Saatvik-Aggarwal/phased-array/README.md

# phased-array
Simulation and design of a phased array for wireless power transmission
