Saatvik-Aggarwal/phased-array/RX Antenna/Rx antenna.kicad_pcb

## KiCad design RX Antenna/Rx antenna.kicad_pcb (2026-04-08)

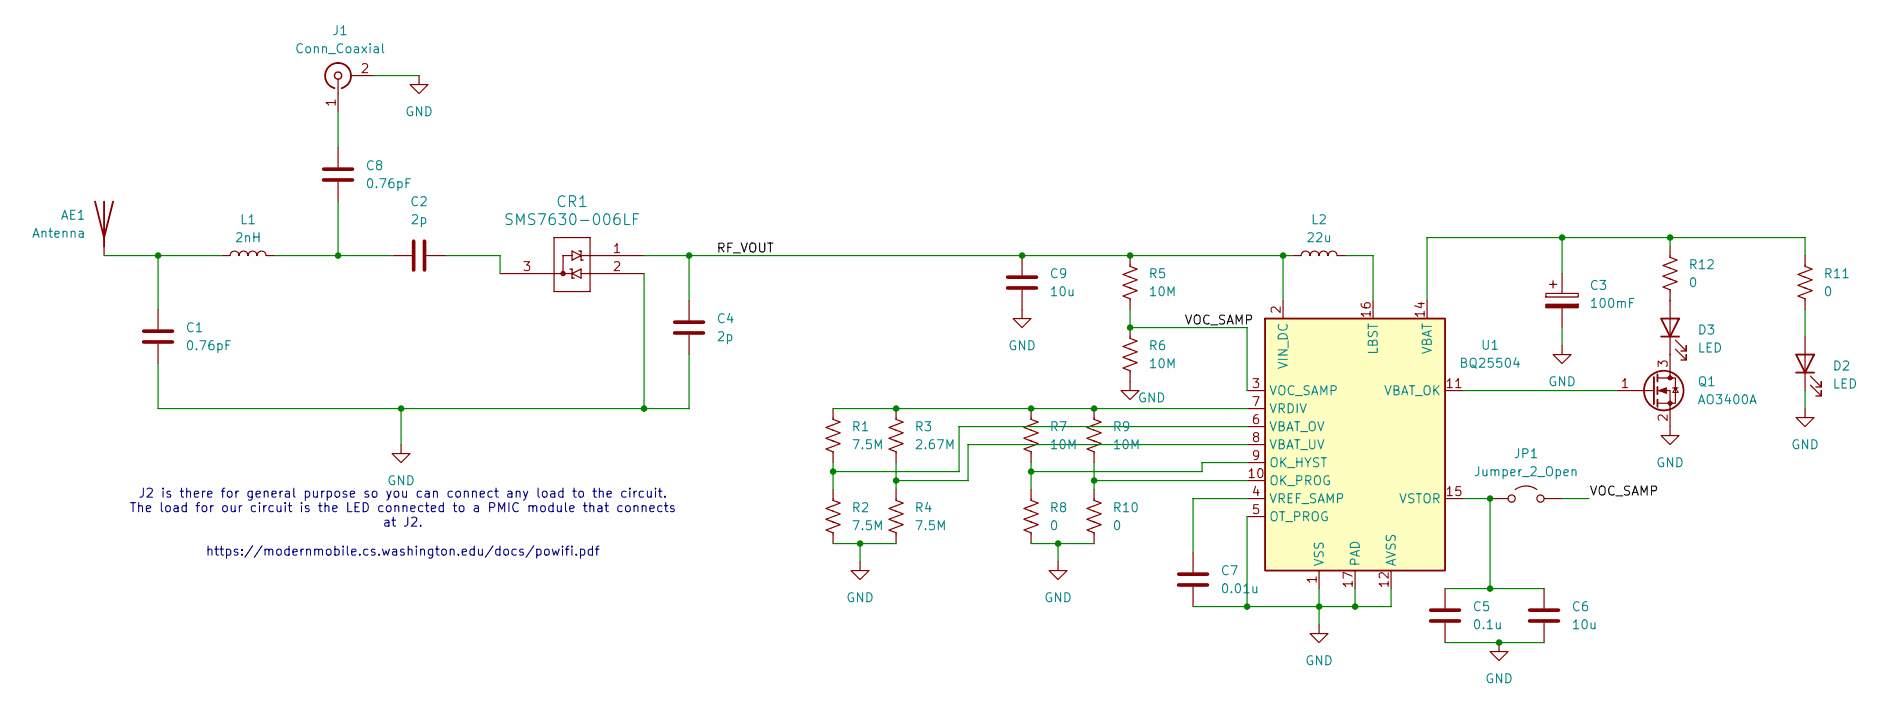
[picture p1: schematic Rx antenna.kicad_sch]

Parts:
AE1: Antenna; AperturePatch
C1: 0.76pF; C_0201_0603Metric_Pad0.64x0.40mm_HandSolder
C2, C4: 2p; C_0201_0603Metric_Pad0.64x0.40mm_HandSolder
C3: 100mF; CP_Radial_D10.0mm_P5.00mm
C5: 0.1u; C_0603_1608Metric_Pad1.08x0.95mm_HandSolder
C6, C9: 10u; C_0603_1608Metric_Pad1.08x0.95mm_HandSolder
C7: 0.01u; C_0603_1608Metric_Pad1.08x0.95mm_HandSolder
C8: 0.76pF; C_0201_branch
CR1: SMS7630-006LF; SOT-23
D2, D3: LED; LED_0603_1608Metric_Pad1.05x0.95mm_HandSolder
J1: Conn_Coaxial; U.FL_Hirose_U.FL-R-SMT-1_Vertical
JP1: Jumper_2_Open; SolderJumper-2_P1.3mm_Open_RoundedPad1.0x1.5mm
L1: 2nH; L_0201_0603Metric_Pad0.64x0.40mm_HandSolder
L2: 22u; L_1210_3225Metric_Pad1.42x2.65mm_HandSolder
Q1: AO3400A; SOT-23
R1, R2, R4: 7.5M; R_0603_1608Metric_Pad0.98x0.95mm_HandSolder
R3: 2.67M; R_0603_1608Metric_Pad0.98x0.95mm_HandSolder
R5, R6, R7, R9: 10M; R_0603_1608Metric_Pad0.98x0.95mm_HandSolder
R8, R10, R11, R12: 0; R_0603_1608Metric_Pad0.98x0.95mm_HandSolder
U1: BQ25504; VQFN-16-1EP_3x3mm_P0.5mm_EP1.68x1.68mm

Connections:
/RF_VOUT: C4.1, C9.1, CR1.1, L2.1, R5.1, U1.2 (VIN_DC)
/VOC_SAMP: JP1.2 (B), R5.2, R6.1, U1.3 (VOC_SAMP)
GND: C1.2, C3.2, C4.2, C5.2, C6.2, C7.2, C9.2, CR1.2, D2.1 (K), J1.2 (Ext), Q1.2 (S), R2.2, R4.2, R6.2, R8.2, R10.2, U1.1 (VSS), U1.5 (OT_PROG), U1.12 (AVSS), U1.13 (VSS), U1.17 (PAD)
unnamed: AE1.1 (A_1), C1.1, L1.1
unnamed: C2.1, C8.1, L1.2
unnamed: C2.2, CR1.3
unnamed: D2.2 (A), R11.2
unnamed: D3.2 (A), R12.2
unnamed: D3.1 (K), Q1.3 (D)
unnamed: C8.2, J1.1 (In)
unnamed: C5.1, C6.1, JP1.1 (A), U1.15 (VSTOR)
unnamed: Q1.1 (G), U1.11 (VBAT_OK)
unnamed: L2.2, U1.16 (LBST)
unnamed: R7.2, R8.1, U1.9 (OK_HYST)
unnamed: R9.2, R10.1, U1.10 (OK_PROG)
unnamed: C3.1, R11.1, R12.1, U1.14 (VBAT)
unnamed: R1.2, R2.1, U1.6 (VBAT_OV)
unnamed: R3.2, R4.1, U1.8 (VBAT_UV)
unnamed: R1.1, R3.1, R7.1, R9.1, U1.7 (VRDIV)
unnamed: C7.1, U1.4 (VREF_SAMP)

Notes on the sheet:
J2 is there for general purpose so you can connect any load to the circuit. The load for our circuit is the LED connected to a PMIC module that connects at J2. https://modernmobile.cs.washington.edu/docs/powifi.pdf

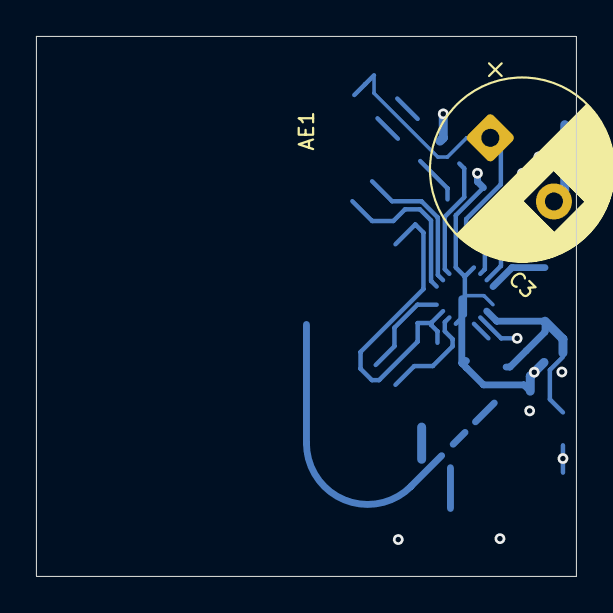
[picture p2: board Rx antenna.kicad_pcb from above]

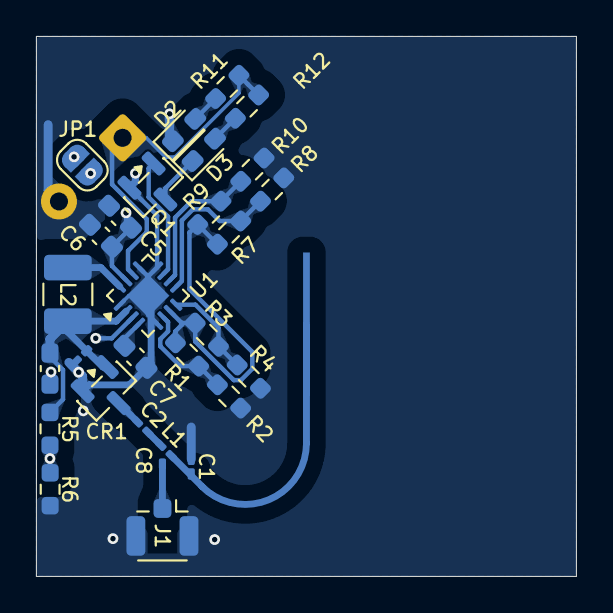
[picture p3: board Rx antenna.kicad_pcb from below]

Board: 4 copper layers, 30.0 x 30.0 mm, 31 parts (29 on the bottom side), 20 nets.
