Saatvik-Aggarwal/phased-array/4phaseshift/4phaseshift.kicad_pcb

## KiCad design 4phaseshift/4phaseshift.kicad_pcb (2026-04-08)

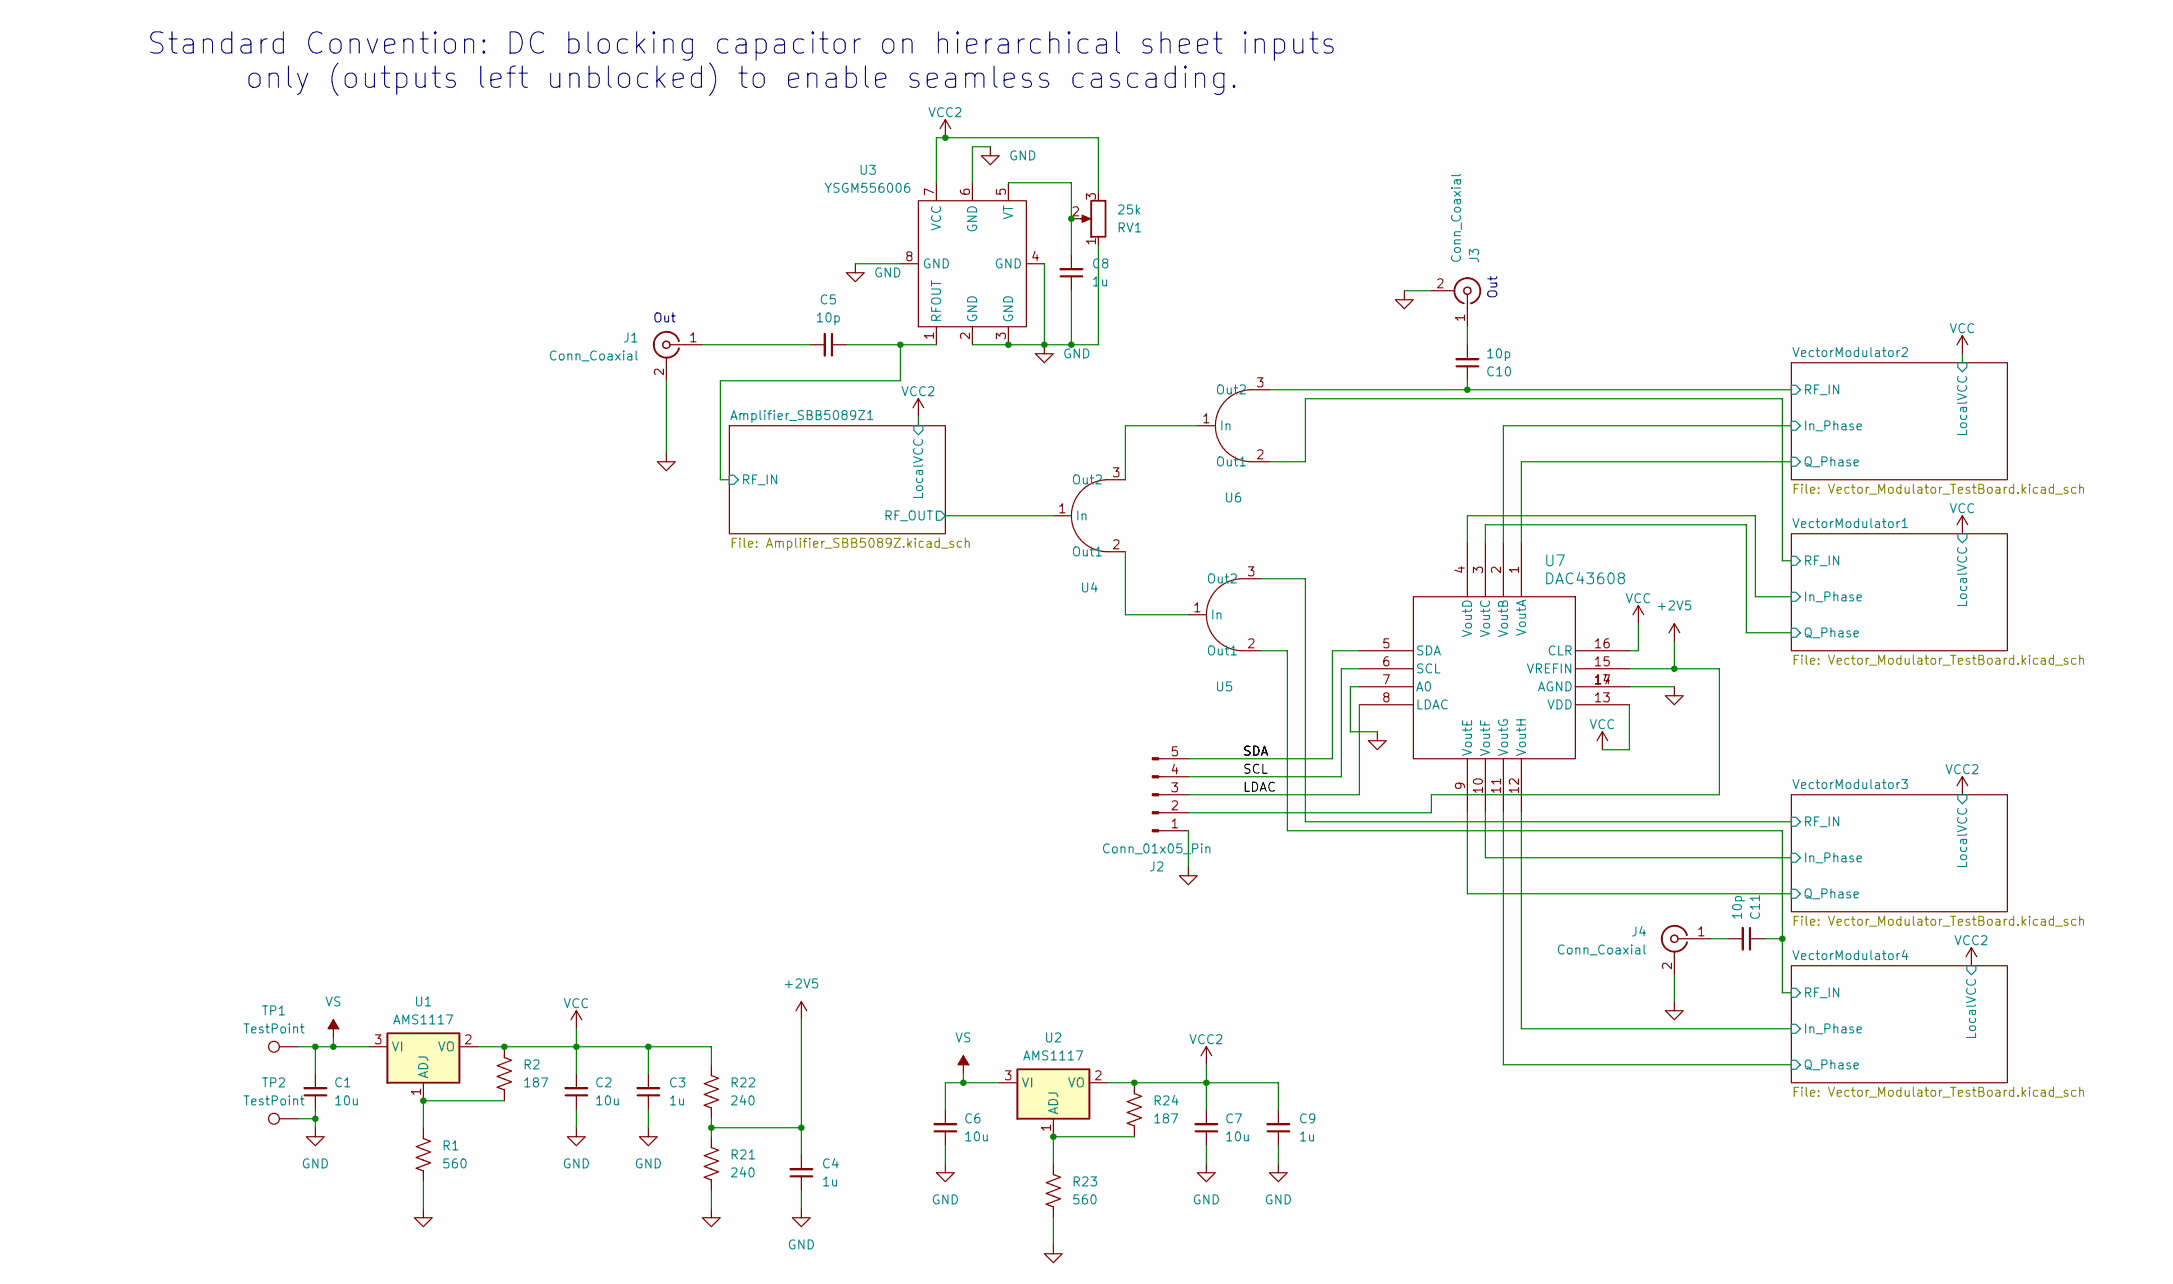
[picture p4: schematic 4phaseshift.kicad_sch]

Parts:
C1, C2, C6, C7: 10u; C_0603_1608Metric_Pad1.08x0.95mm_HandSolder
C3, C4, C8, C9: 1u; C_0603_1608Metric_Pad1.08x0.95mm_HandSolder
C5, C10, C11: 10p; C_0201_branch
J1, J3, J4: Conn_Coaxial; U.FL_Hirose_U.FL-R-SMT-1_Vertical
J2: Conn_01x05_Pin; PinHeader_1x05_P2.54mm_Vertical
R1, R23: 560; R_0603_1608Metric_Pad0.98x0.95mm_HandSolder
R2, R24: 187; R_0603_1608Metric_Pad0.98x0.95mm_HandSolder
R21, R22: 240; R_0603_1608Metric_Pad0.98x0.95mm_HandSolder
RV1: 25k; Potentiometer_Bourns_3386X_Horizontal
TP1, TP2: TestPoint; PinHeader_1x01_P2.54mm_Vertical
U1, U2: AMS1117; SOT-223-3_TabPin2
U3: YSGM556006; Innotion9070
U4, U5, U6: T_Splitter
U7: DAC43608; WQFN-16-1EP_3x3mm_P0.5mm_EP1.68x1.68mm

Connections:
+2V5: C4.2, J2.2, R21.1, R22.2, U7.15 (VREFIN)
/Amplifier_SBB5089Z1/RF_IN: C5.1, U3.1 (RFOUT); also elsewhere on the board
/Amplifier_SBB5089Z1/RF_OUT: U4.1 (In); also elsewhere on the board
/LDAC: J2.3, U7.8 (LDAC)
/SCL: J2.4, U7.6 (SCL)
/VectorModulator1/IBBN: U7.4 (VoutD); also elsewhere on the board
/VectorModulator1/QBBN: U7.3 (VoutC); also elsewhere on the board
/VectorModulator1/RF_IN: U6.2 (Out1); also elsewhere on the board
/VectorModulator2/IBBN: U7.2 (VoutB); also elsewhere on the board
/VectorModulator2/QBBN: U7.1 (VoutA); also elsewhere on the board
/VectorModulator2/RF_IN: C10.1, U6.3 (Out2); also elsewhere on the board
/VectorModulator3/IBBN: U7.10 (VoutF); also elsewhere on the board
/VectorModulator3/QBBN: U7.9 (VoutE); also elsewhere on the board
/VectorModulator3/RF_IN: U5.3 (Out2); also elsewhere on the board
/VectorModulator4/IBBN: U7.12 (VoutH); also elsewhere on the board
/VectorModulator4/QBBN: U7.11 (VoutG); also elsewhere on the board
/VectorModulator4/RF_IN: C11.1, U5.2 (Out1); also elsewhere on the board
GND: C1.1, C2.1, C3.1, C4.1, C6.1, C7.1, C8.1, C9.1, J1.2 (Ext), J2.1, J3.2 (Ext), J4.2 (Ext), R1.2, R21.2, R23.2, RV1.1, TP2.1, U3.2 (GND), U3.3 (GND), U3.4 (GND), U3.6 (GND), U3.8 (GND), U7.7 (A0), U7.14 (AGND), U7.17 (AGND); also elsewhere on the board
unnamed: C5.2, J1.1 (In)
unnamed: J2.5, U7.5 (SDA)
unnamed: C10.2, J3.1 (In)
unnamed: C11.2, J4.1 (In)
unnamed: R1.1, R2.2, U1.1 (ADJ)
unnamed: R23.1, R24.2, U2.1 (ADJ)
unnamed: C8.2, RV1.2, U3.5 (VT)
unnamed: U4.2 (Out1), U5.1 (In)
unnamed: U4.3 (Out2), U6.1 (In)
VCC: C2.2, C3.2, R2.1, R22.1, U1.2 (VO), U7.13 (VDD), U7.16 (CLR); also elsewhere on the board
VCC2: C7.2, C9.2, R24.1, RV1.3, U2.2 (VO), U3.7 (VCC); also elsewhere on the board
VS: C1.2, C6.2, TP1.1, U1.3 (VI), U2.3 (VI); also elsewhere on the board

Notes on the sheet:
Out
Standard Convention: DC blocking capacitor on hierarchical sheet inputs only (outputs left unblocked) to enable seamless cascading.

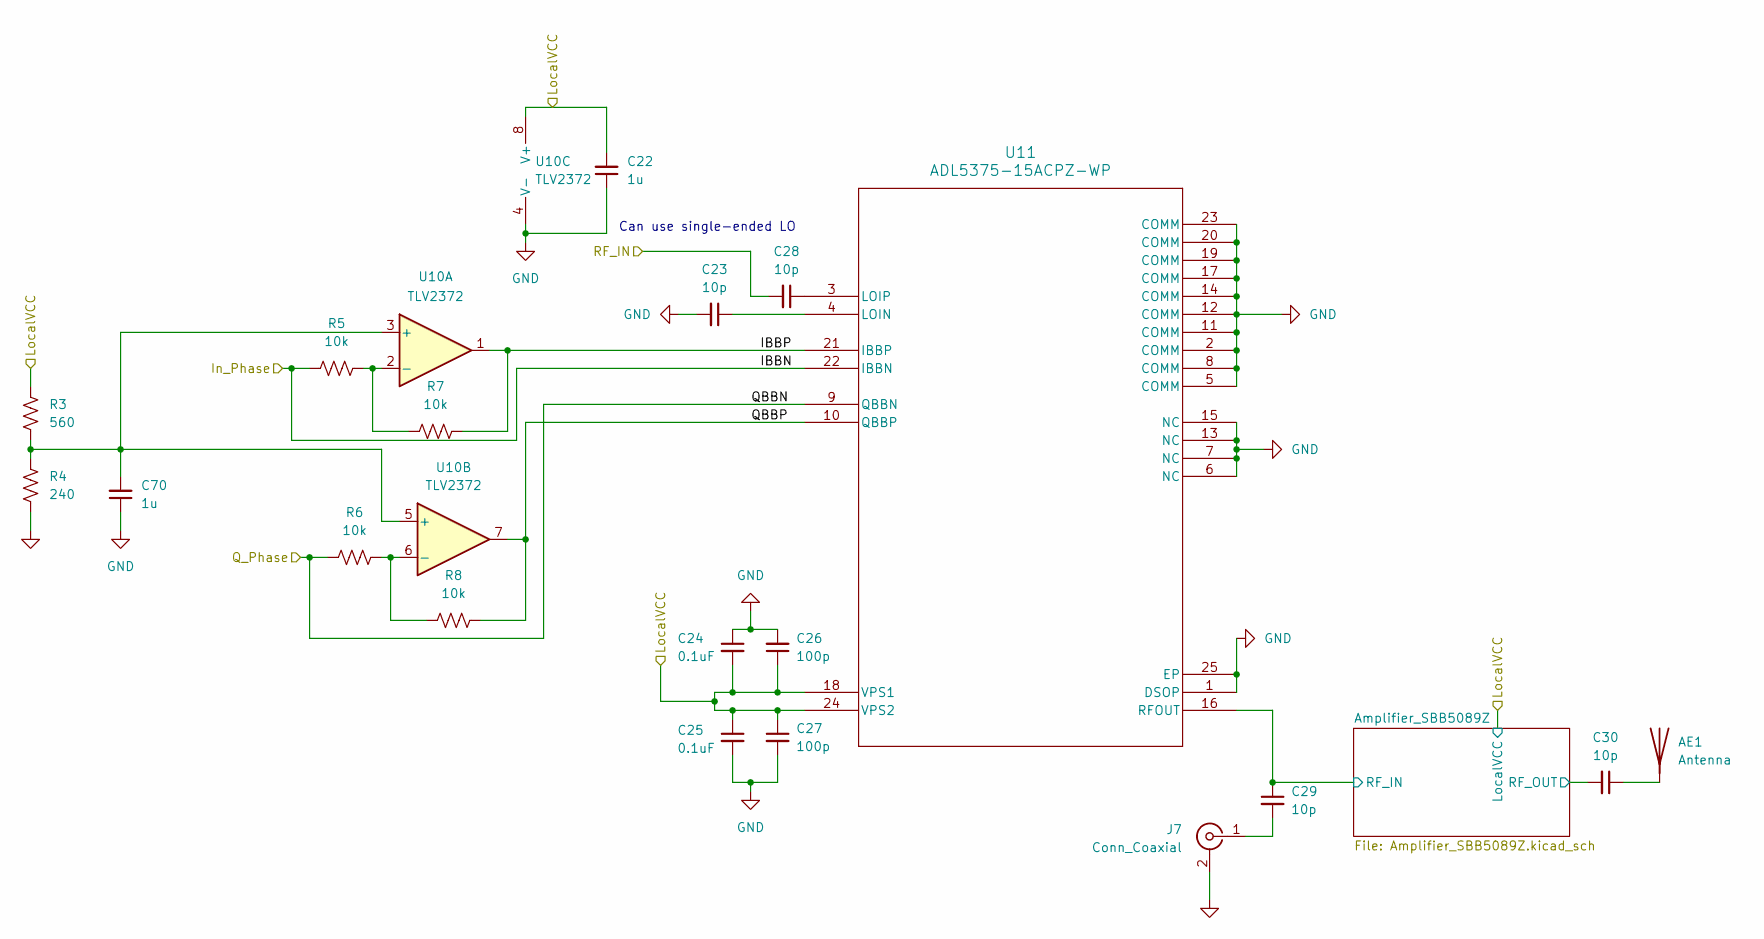
[picture p5: schematic Vector_Modulator_TestBoard.kicad_sch]

Parts:
AE1: Antenna; AperturePatch
C22, C70: 1u; C_0603_1608Metric_Pad1.08x0.95mm_HandSolder
C23, C28, C30: 10p; C_0201_0603Metric_Pad0.64x0.40mm_HandSolder
C24, C25: 0.1uF; C_0603_1608Metric_Pad1.08x0.95mm_HandSolder
C26, C27: 100p; C_0603_1608Metric_Pad1.08x0.95mm_HandSolder
C29: 10p; C_0201_branch
J7: Conn_Coaxial; U.FL_Hirose_U.FL-R-SMT-1_Vertical
R3: 560; R_0603_1608Metric_Pad0.98x0.95mm_HandSolder
R4: 240; R_0603_1608Metric_Pad0.98x0.95mm_HandSolder
R5, R6, R7, R8: 10k; R_0603_1608Metric_Pad0.98x0.95mm_HandSolder
U10: TLV2372; SOIC-8_3.9x4.9mm_P1.27mm
U11: ADL5375-15ACPZ-WP; LFCSP-24-1EP_4x4mm_P0.5mm_EP2.3x2.3mm_ThermalVias

Connections:
/VectorModulator1/Amplifier_SBB5089Z/RF_IN: C29.1, U11.16 (RFOUT); also elsewhere on the board
/VectorModulator1/Amplifier_SBB5089Z/RF_OUT: C30.2; also elsewhere on the board
/VectorModulator1/IBBN: R5.1, U11.22 (IBBN); also elsewhere on the board
/VectorModulator1/IBBP: R7.2, U10.1, U11.21 (IBBP)
/VectorModulator1/QBBN: R6.1, U11.9 (QBBN); also elsewhere on the board
/VectorModulator1/QBBP: R8.2, U10.7, U11.10 (QBBP)
/VectorModulator1/RF_IN: C28.2; also elsewhere on the board
GND: C22.1, C23.2, C24.1, C25.2, C26.2, C27.2, C70.1, J7.2 (Ext), R4.2, U10.4 (V-), U11.1 (DSOP), U11.2 (COMM), U11.5 (COMM), U11.6 (NC), U11.7 (NC), U11.8 (COMM), U11.11 (COMM), U11.12 (COMM), U11.13 (NC), U11.14 (COMM), U11.15 (NC), U11.17 (COMM), U11.19 (COMM), U11.20 (COMM), U11.23 (COMM), U11.25 (EP); also elsewhere on the board
unnamed: AE1.1 (A_1), C30.1
unnamed: C29.2, J7.1 (In)
unnamed: C70.2, R3.2, R4.1, U10.3 (+), U10.5 (+)
unnamed: R5.2, R7.1, U10.2 (-)
unnamed: R6.2, R8.1, U10.6 (-)
unnamed: C23.1, U11.4 (LOIN)
unnamed: C28.1, U11.3 (LOIP)
VCC: C22.2, C24.2, C25.1, C26.1, C27.1, R3.1, U10.8 (V+), U11.18 (VPS1), U11.24 (VPS2); also elsewhere on the board

Parts of its further copies:
AE2, AE3, AE4: Antenna; AperturePatch
C31, C44, C57, C71, C72, C73: 1u; C_0603_1608Metric_Pad1.08x0.95mm_HandSolder
C32, C37, C39, C45, C50, C52, C58, C63, C65: 10p; C_0201_0603Metric_Pad0.64x0.40mm_HandSolder
C33, C34, C46, C47, C59, C60: 0.1uF; C_0603_1608Metric_Pad1.08x0.95mm_HandSolder
C35, C36, C48, C49, C61, C62: 100p; C_0603_1608Metric_Pad1.08x0.95mm_HandSolder
C38, C51, C64: 10p; C_0201_branch
J8, J9, J10: Conn_Coaxial; U.FL_Hirose_U.FL-R-SMT-1_Vertical
R9, R10, R11, R12, R13, R14, R15, R16, R17, R18, R19, R20: 10k; R_0603_1608Metric_Pad0.98x0.95mm_HandSolder
R30, R32, R34: 560; R_0603_1608Metric_Pad0.98x0.95mm_HandSolder
R31, R33, R35: 240; R_0603_1608Metric_Pad0.98x0.95mm_HandSolder
U12, U15, U18: TLV2372; SOIC-8_3.9x4.9mm_P1.27mm
U13, U16, U19: ADL5375-15ACPZ-WP; LFCSP-24-1EP_4x4mm_P0.5mm_EP2.3x2.3mm_ThermalVias

Connections of its further copies:
/VectorModulator2/Amplifier_SBB5089Z/RF_IN: C38.1, U13.16 (RFOUT); also elsewhere on the board
/VectorModulator2/Amplifier_SBB5089Z/RF_OUT: C39.2; also elsewhere on the board
/VectorModulator2/IBBN: R9.1, U13.22 (IBBN); also elsewhere on the board
/VectorModulator2/IBBP: R11.2, U12.1, U13.21 (IBBP)
/VectorModulator2/QBBN: R10.1, U13.9 (QBBN); also elsewhere on the board
/VectorModulator2/QBBP: R12.2, U12.7, U13.10 (QBBP)
/VectorModulator2/RF_IN: C37.2; also elsewhere on the board
/VectorModulator3/Amplifier_SBB5089Z/RF_IN: C51.1, U16.16 (RFOUT); also elsewhere on the board
/VectorModulator3/Amplifier_SBB5089Z/RF_OUT: C52.2; also elsewhere on the board
/VectorModulator3/IBBN: R13.1, U16.22 (IBBN); also elsewhere on the board
/VectorModulator3/IBBP: R15.2, U15.1, U16.21 (IBBP)
/VectorModulator3/QBBN: R14.1, U16.9 (QBBN); also elsewhere on the board
/VectorModulator3/QBBP: R16.2, U15.7, U16.10 (QBBP)
/VectorModulator3/RF_IN: C50.2; also elsewhere on the board
/VectorModulator4/Amplifier_SBB5089Z/RF_IN: C64.1, U19.16 (RFOUT); also elsewhere on the board
/VectorModulator4/Amplifier_SBB5089Z/RF_OUT: C65.2; also elsewhere on the board
/VectorModulator4/IBBN: R17.1, U19.22 (IBBN); also elsewhere on the board
/VectorModulator4/IBBP: R19.2, U18.1, U19.21 (IBBP)
/VectorModulator4/QBBN: R18.1, U19.9 (QBBN); also elsewhere on the board
/VectorModulator4/QBBP: R20.2, U18.7, U19.10 (QBBP)
/VectorModulator4/RF_IN: C63.2; also elsewhere on the board
GND: C31.1, C32.2, C33.1, C34.2, C35.2, C36.2, C44.1, C45.2, C46.1, C47.2, C48.2, C49.2, C57.1, C58.2, C59.1, C60.2, C61.2, C62.2, C71.1, C72.1, C73.1, J8.2 (Ext), J9.2 (Ext), J10.2 (Ext), R31.2, R33.2, R35.2, U12.4 (V-), U13.1 (DSOP), U13.2 (COMM), U13.5 (COMM), U13.6 (NC), U13.7 (NC), U13.8 (COMM), U13.11 (COMM), U13.12 (COMM), U13.13 (NC), U13.14 (COMM), U13.15 (NC), U13.17 (COMM), U13.19 (COMM), U13.20 (COMM), U13.23 (COMM), U13.25 (EP), U15.4 (V-), U16.1 (DSOP), U16.2 (COMM), U16.5 (COMM), U16.6 (NC), U16.7 (NC), U16.8 (COMM), U16.11 (COMM), U16.12 (COMM), U16.13 (NC), U16.14 (COMM), U16.15 (NC), U16.17 (COMM), U16.19 (COMM), U16.20 (COMM), U16.23 (COMM), U16.25 (EP), U18.4 (V-), U19.1 (DSOP), U19.2 (COMM), U19.5 (COMM), U19.6 (NC), U19.7 (NC), U19.8 (COMM), U19.11 (COMM), U19.12 (COMM), U19.13 (NC), U19.14 (COMM), U19.15 (NC), U19.17 (COMM), U19.19 (COMM), U19.20 (COMM), U19.23 (COMM), U19.25 (EP); also elsewhere on the board
unnamed: AE2.1 (A_1), C39.1
unnamed: AE3.1 (A_1), C52.1
unnamed: AE4.1 (A_1), C65.1
unnamed: C38.2, J8.1 (In)
unnamed: C51.2, J9.1 (In)
unnamed: C64.2, J10.1 (In)
unnamed: C71.2, R30.2, R31.1, U12.3 (+), U12.5 (+)
unnamed: R9.2, R11.1, U12.2 (-)
unnamed: R10.2, R12.1, U12.6 (-)
unnamed: C32.1, U13.4 (LOIN)
unnamed: C37.1, U13.3 (LOIP)
unnamed: C72.2, R32.2, R33.1, U15.3 (+), U15.5 (+)
unnamed: R13.2, R15.1, U15.2 (-)
unnamed: R14.2, R16.1, U15.6 (-)
unnamed: C45.1, U16.4 (LOIN)
unnamed: C50.1, U16.3 (LOIP)
unnamed: C73.2, R34.2, R35.1, U18.3 (+), U18.5 (+)
unnamed: R17.2, R19.1, U18.2 (-)
unnamed: R18.2, R20.1, U18.6 (-)
unnamed: C58.1, U19.4 (LOIN)
unnamed: C63.1, U19.3 (LOIP)
VCC: C31.2, C33.2, C34.1, C35.1, C36.1, R30.1, U12.8 (V+), U13.18 (VPS1), U13.24 (VPS2); also elsewhere on the board
VCC2: C44.2, C46.2, C47.1, C48.1, C49.1, C57.2, C59.2, C60.1, C61.1, C62.1, R32.1, R34.1, U15.8 (V+), U16.18 (VPS1), U16.24 (VPS2), U18.8 (V+), U19.18 (VPS1), U19.24 (VPS2); also elsewhere on the board

Notes on the sheet:
Can use single-ended LO

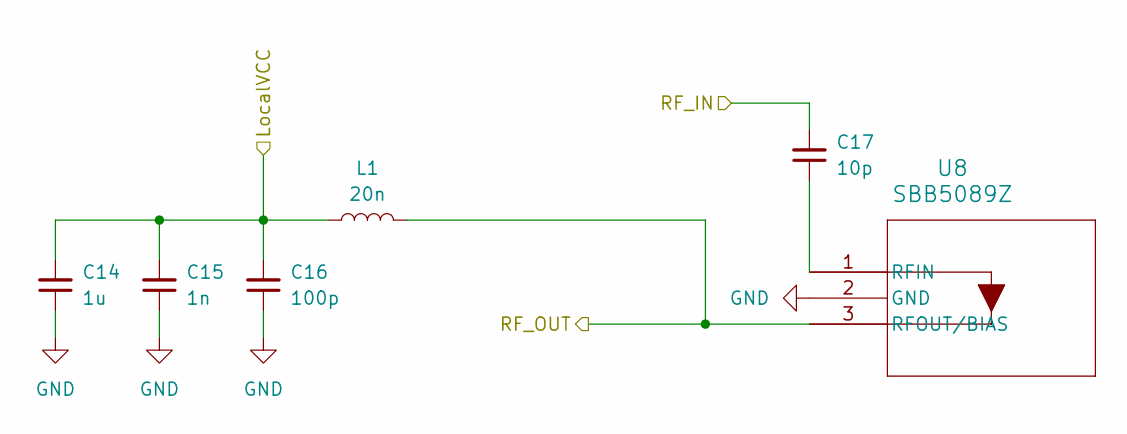
[picture p6: schematic Amplifier_SBB5089Z.kicad_sch]

Parts:
C14: 1u; C_0603_1608Metric_Pad1.08x0.95mm_HandSolder
C15: 1n; C_0603_1608Metric_Pad1.08x0.95mm_HandSolder
C16: 100p; C_0603_1608Metric_Pad1.08x0.95mm_HandSolder
C17: 10p; C_0201_0603Metric_Pad0.64x0.40mm_HandSolder
L1: 20n; L_0402_1005Metric_Pad0.77x0.64mm_HandSolder
U8: SBB5089Z; SOT_SBB5089Z_QOR

Connections:
/VectorModulator1/Amplifier_SBB5089Z/RF_IN: C17.2; also elsewhere on the board
/VectorModulator1/Amplifier_SBB5089Z/RF_OUT: L1.2, U8.3 (RFOUT/BIAS); also elsewhere on the board
GND: C14.1, C15.1, C16.1, U8.2 (GND); also elsewhere on the board
unnamed: C17.1, U8.1 (RFIN)
VCC: C14.2, C15.2, C16.2, L1.1; also elsewhere on the board

Parts of its further copies:
C18, C40, C53, C66: 1u; C_0603_1608Metric_Pad1.08x0.95mm_HandSolder
C19, C41, C54, C67: 1n; C_0603_1608Metric_Pad1.08x0.95mm_HandSolder
C20, C42, C55, C68: 100p; C_0603_1608Metric_Pad1.08x0.95mm_HandSolder
C21, C43, C56, C69: 10p; C_0201_0603Metric_Pad0.64x0.40mm_HandSolder
L2, L3, L4, L5: 20n; L_0402_1005Metric_Pad0.77x0.64mm_HandSolder
U9, U14, U17, U20: SBB5089Z; SOT_SBB5089Z_QOR

Connections of its further copies:
/Amplifier_SBB5089Z1/RF_IN: C21.2; also elsewhere on the board
/Amplifier_SBB5089Z1/RF_OUT: L2.2, U9.3 (RFOUT/BIAS); also elsewhere on the board
/VectorModulator2/Amplifier_SBB5089Z/RF_IN: C43.2; also elsewhere on the board
/VectorModulator2/Amplifier_SBB5089Z/RF_OUT: L3.2, U14.3 (RFOUT/BIAS); also elsewhere on the board
/VectorModulator3/Amplifier_SBB5089Z/RF_IN: C56.2; also elsewhere on the board
/VectorModulator3/Amplifier_SBB5089Z/RF_OUT: L4.2, U17.3 (RFOUT/BIAS); also elsewhere on the board
/VectorModulator4/Amplifier_SBB5089Z/RF_IN: C69.2; also elsewhere on the board
/VectorModulator4/Amplifier_SBB5089Z/RF_OUT: L5.2, U20.3 (RFOUT/BIAS); also elsewhere on the board
GND: C18.1, C19.1, C20.1, C40.1, C41.1, C42.1, C53.1, C54.1, C55.1, C66.1, C67.1, C68.1, U9.2 (GND), U14.2 (GND), U17.2 (GND), U20.2 (GND); also elsewhere on the board
unnamed: C21.1, U9.1 (RFIN)
unnamed: C43.1, U14.1 (RFIN)
unnamed: C56.1, U17.1 (RFIN)
unnamed: C69.1, U20.1 (RFIN)
VCC: C40.2, C41.2, C42.2, L3.1; also elsewhere on the board
VCC2: C18.2, C19.2, C20.2, C53.2, C54.2, C55.2, C66.2, C67.2, C68.2, L2.1, L4.1, L5.1; also elsewhere on the board

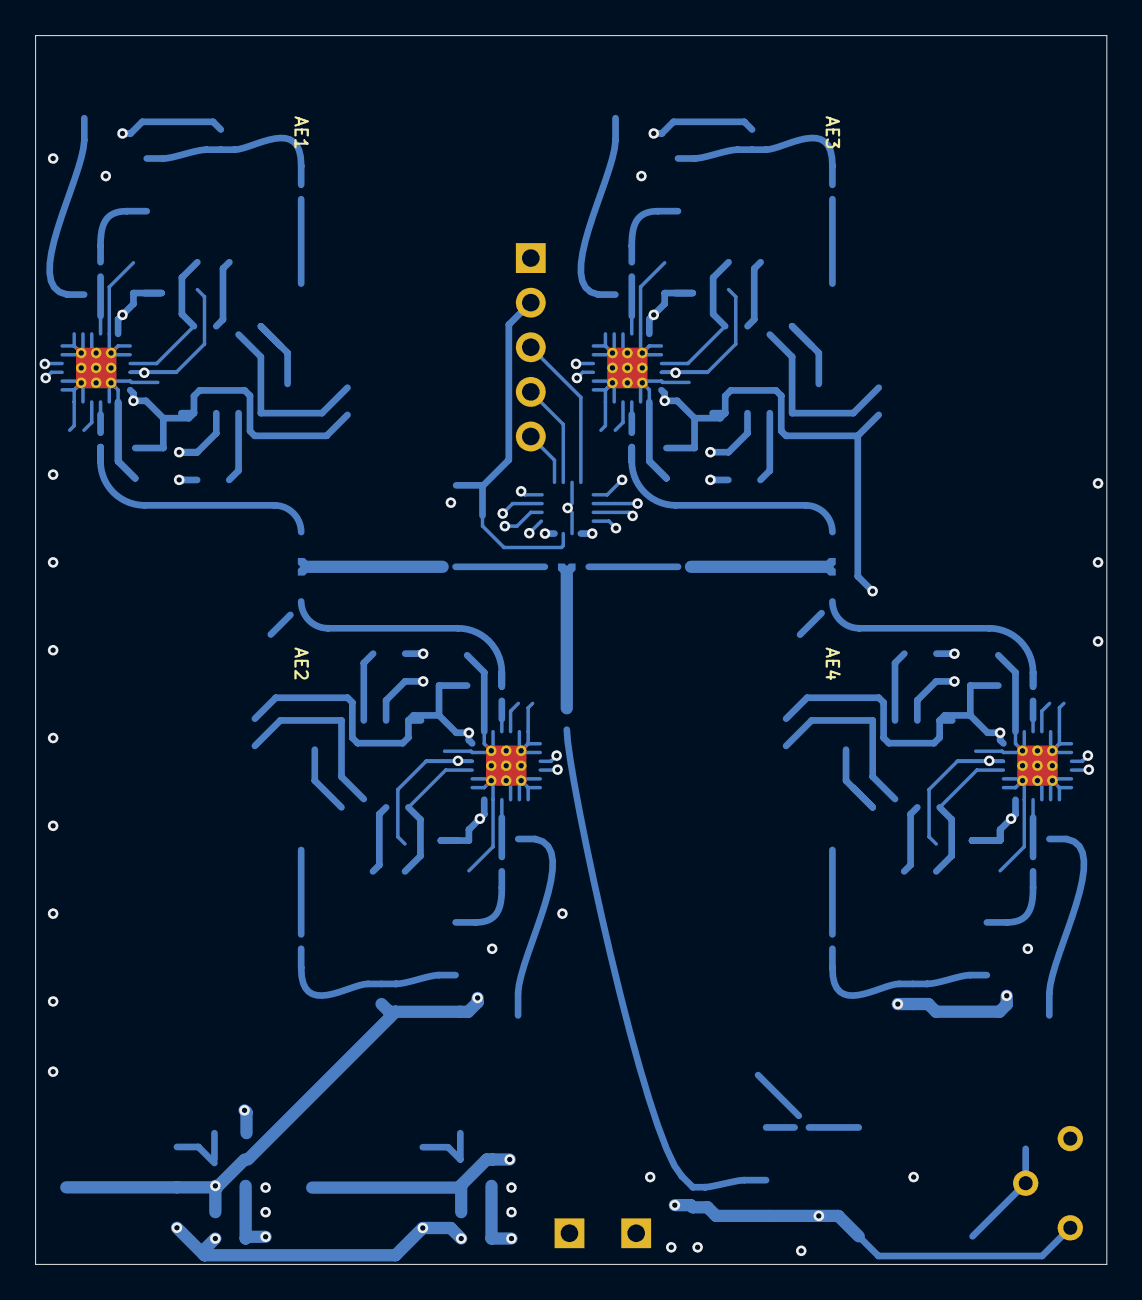
[picture p7: board 4phaseshift.kicad_pcb from above]

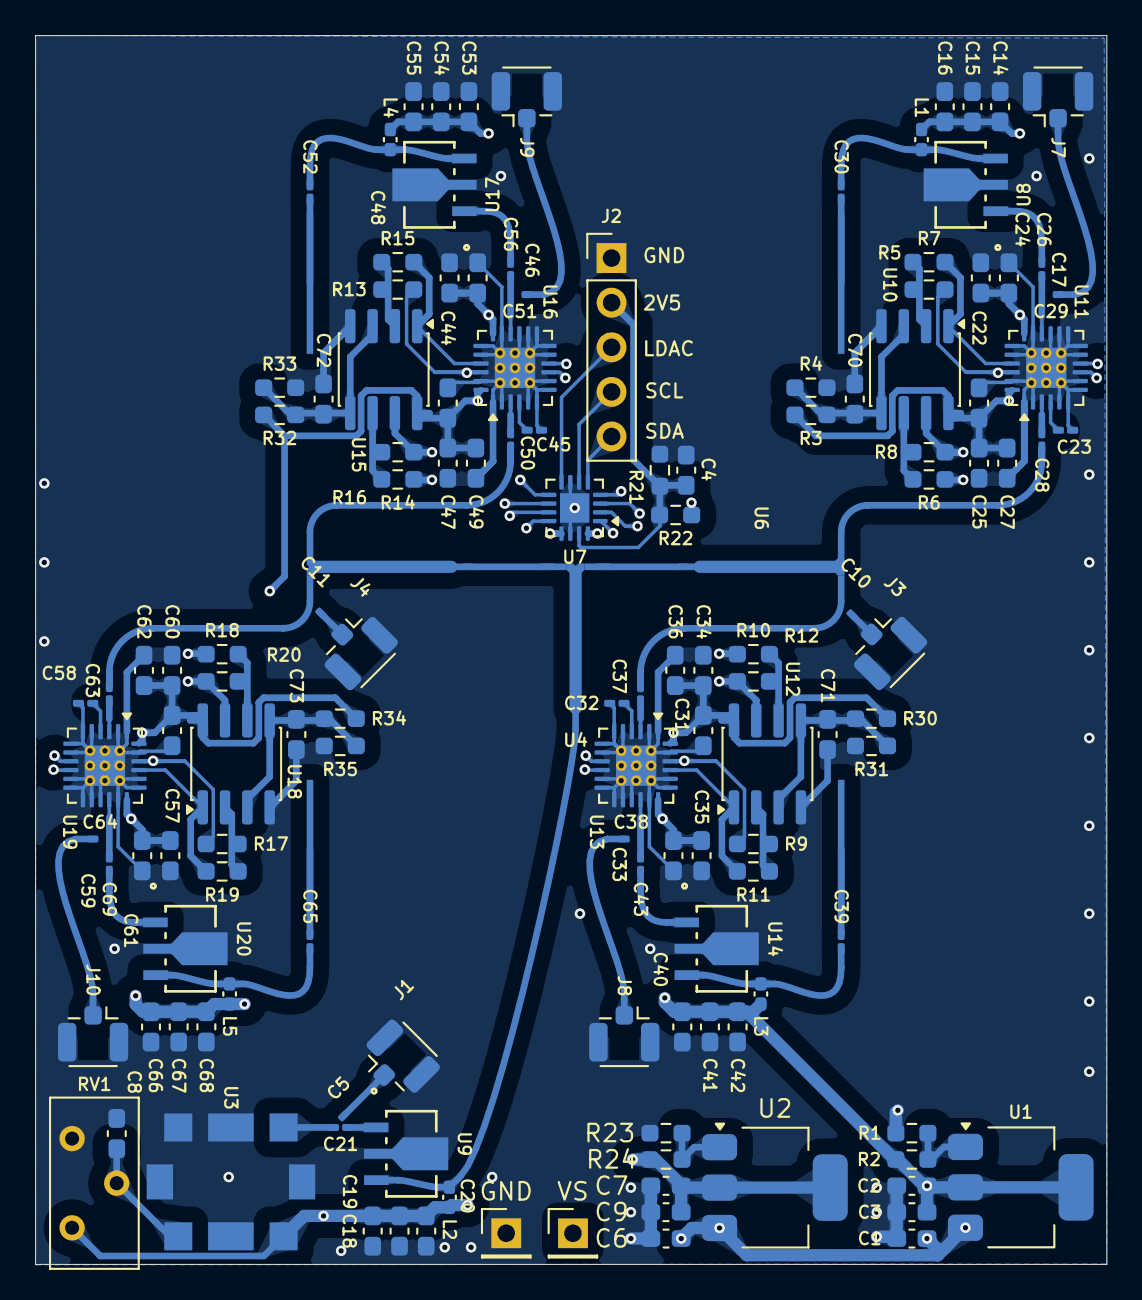
[picture p8: board 4phaseshift.kicad_pcb from below]

Board: 4 copper layers, 61.0 x 70.0 mm, 141 parts (137 on the bottom side), 79 nets.

Other parts of the board:
GND: TestPoint; PinHeader_1x01_P2.54mm_Vertical
VS: TestPoint; PinHeader_1x01_P2.54mm_Vertical

Their connections:
GND: GND.1; also elsewhere on the board
VS: VS.1; also elsewhere on the board
