Saatvik-Aggarwal/phased-array/testPCB/switchedPhaseShift.kicad_pcb

## KiCad design testPCB/switchedPhaseShift.kicad_pcb (2026-02-13)

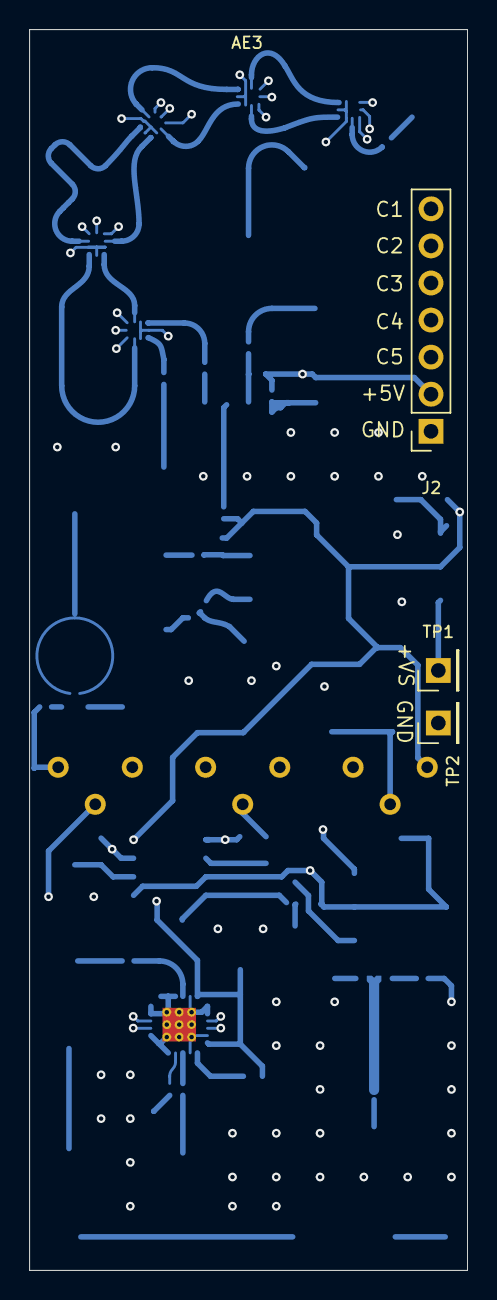
[picture p9: board switchedPhaseShift.kicad_pcb from above]

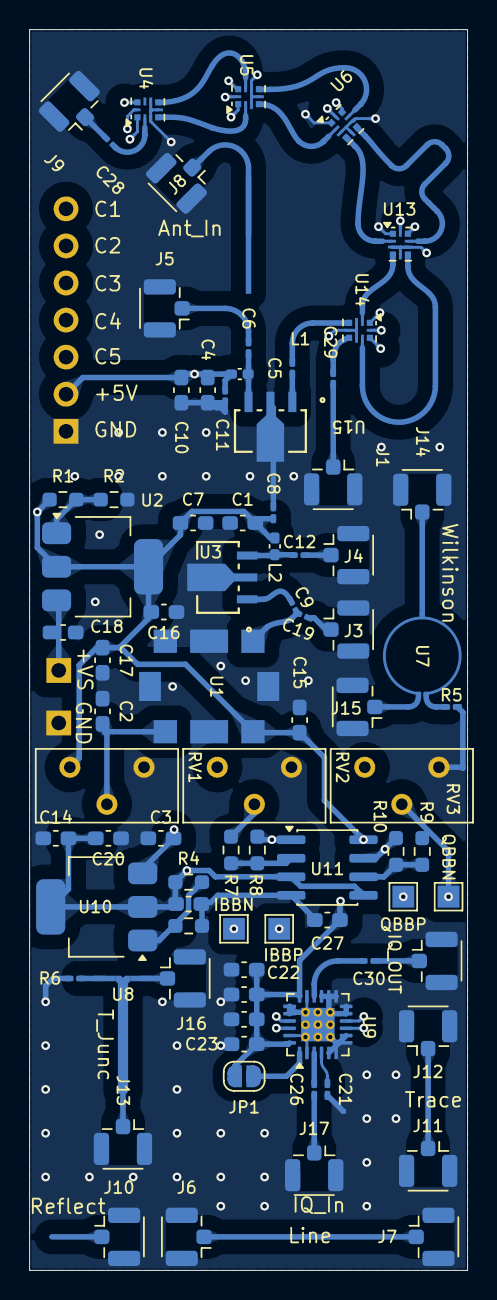
[picture p10: board switchedPhaseShift.kicad_pcb from below]

Board: 4 copper layers, 30.0 x 85.0 mm, 85 parts (81 on the bottom side), 54 nets.

Parts:
AE3: Antenna; AperturePatch
C1, C2, C4, C14, C15, C27: 1u; C_0603_1608Metric_Pad1.08x0.95mm_HandSolder
C3, C13, C17, C18: 10u; C_0603_1608Metric_Pad1.08x0.95mm_HandSolder
C5, C6, C9, C12, C19, C21, C26, C28, C29, C30: 8.2p; C_0201_0603Metric_Pad0.64x0.40mm_HandSolder
C7, C10, C16, C20: 1n; C_0603_1608Metric_Pad1.08x0.95mm_HandSolder
C8, C11: 68p; C_0201_0603Metric_Pad0.64x0.40mm_HandSolder
C22, C23: 0.1uF; C_0603_1608Metric_Pad1.08x0.95mm_HandSolder
C24, C25: 100pF; C_0603_1608Metric_Pad1.08x0.95mm_HandSolder
IBBN: TB_IBBN; TestPoint_Pad_1.5x1.5mm
IBBP: TP_IBBP; TestPoint_Pad_1.5x1.5mm
IQ_OUT: Conn_Coaxial; U.FL_Hirose_U.FL-R-SMT-1_Vertical
J1, J3, J4, J5, J6, J7, J8, J9, J10, J11, J12, J13, J14, J15, J16, J17: Conn_Coaxial; U.FL_Hirose_U.FL-R-SMT-1_Vertical
J2: Conn_01x07_Pin; PinSocket_1x07_P2.54mm_Vertical
JP1: Jumper_2_Open; SolderJumper-2_P1.3mm_Open_RoundedPad1.0x1.5mm
L1, L2: 82n; L_0402_1005Metric_Pad0.77x0.64mm_HandSolder
QBBN: TP_QBBN; TestPoint_Pad_1.5x1.5mm
QBBP: TP_QBBP; TestPoint_Pad_1.5x1.5mm
R1: 30k; R_0603_1608Metric_Pad0.98x0.95mm_HandSolder
R2, R3: 10k; R_0603_1608Metric_Pad0.98x0.95mm_HandSolder
R4: 2k; R_0603_1608Metric_Pad0.98x0.95mm_HandSolder
R5, R6: 50; R_0201_0603Metric_Pad0.64x0.40mm_HandSolder
R7, R8, R9, R10: 100k; R_0603_1608Metric_Pad0.98x0.95mm_HandSolder
RV1, RV2, RV3: 25k; Potentiometer_Bourns_3386X_Horizontal
TP1, TP2: TestPoint; PinHeader_1x01_P2.54mm_Vertical
U1: YSGM556006; Innotion9070
U2, U10: AMS1117; SOT-223-3_TabPin2
U3, U15: SBB5089Z; SOT_SBB5089Z_QOR
U4, U5, U6, U13, U14: SKY13699-21
U7: WilkinsonPowerDivider
U8: T_Splitter
U9: ADL5375-15ACPZ-WP; LFCSP-24-1EP_4x4mm_P0.5mm_EP2.3x2.3mm_ThermalVias
U11: TLV2372; SOIC-8_3.9x4.9mm_P1.27mm

Connections:
+1V5: C13.2, C14.2, C20.2, R4.1, RV2.3, RV3.3, U10.2 (VO), U11.3 (+), U11.5 (+)
/Amplifier_SBB5089Z1/RF_IN: C9.2, C19.1, U1.1 (RFOUT)
/Amplifier_SBB5089Z1/RF_OUT: C12.2, L2.2, U3.3 (RFOUT/BIAS)
/Amplifier_SBB5089Z/RF_IN: C5.2, U14.4 (RF1)
/Amplifier_SBB5089Z/RF_OUT: C6.2, L1.2, U15.3 (RFOUT/BIAS)
/SL_PhaseShift1/C1: J2.7, U4.9 (CTL1)
/SL_PhaseShift1/C2: J2.6, U5.9 (CTL1)
/SL_PhaseShift1/C3: J2.5, U6.9 (CTL1)
/SL_PhaseShift1/C4: J2.4, U13.9 (CTL1)
/SL_PhaseShift1/C5: J2.3, U14.9 (CTL1)
/SL_PhaseShift1/RF_IN: C28.2, J9.1 (In)
/SL_PhaseShift1/RF_OUT2: C29.2, U14.6 (RF2)
/VectorModulator/IBBN: IBBN.1, R7.1, RV2.2, U9.22 (IBBN)
/VectorModulator/IBBP: IBBP.1, R8.2, U9.21 (IBBP), U11.1
/VectorModulator/QBBN: QBBN.1, R9.1, RV3.2, U9.9 (QBBN)
/VectorModulator/QBBP: QBBP.1, R10.2, U9.10 (QBBP), U11.7
/VectorModulator/RF_IN: C26.2, J17.1 (In)
/VectorModulator/RF_OUT: C30.2, U9.16 (RFOUT)
GND: C1.1, C2.1, C3.1, C4.1, C7.1, C8.1, C10.1, C11.1, C13.1, C14.1, C15.1, C16.1, C17.1, C18.1, C20.1, C21.2, C22.1, C23.2, C24.2, C25.2, C27.1, IQ_OUT.2 (Ext), J1.2 (Ext), J2.1, J3.2 (Ext), J4.2 (Ext), J5.2 (Ext), J6.2 (Ext), J7.2 (Ext), J8.2 (Ext), J9.2 (Ext), J10.2 (Ext), J11.2 (Ext), J12.2 (Ext), J13.2 (Ext), J14.2 (Ext), J15.2 (Ext), J16.2 (Ext), J17.2 (Ext), R2.2, R3.2, R5.2, R6.2, RV1.1, RV2.1, RV3.1, TP2.1, U1.2 (GND), U1.3 (GND), U1.4 (GND), U1.6 (GND), U1.8 (GND), U3.2 (GND), U4.1 (GND), U4.3 (GND), U4.5 (GND), U4.7 (GND), U5.1 (GND), U5.3 (GND), U5.5 (GND), U5.7 (GND), U6.1 (GND), U6.3 (GND), U6.5 (GND), U6.7 (GND), U9.2 (COMM), U9.5 (COMM), U9.6 (NC), U9.7 (NC), U9.8 (COMM), U9.11 (COMM), U9.12 (COMM), U9.13 (NC), U9.14 (COMM), U9.15 (NC), U9.17 (COMM), U9.19 (COMM), U9.20 (COMM), U9.23 (COMM), U9.25 (EP), U11.4 (V-), U13.1 (GND), U13.3 (GND), U13.5 (GND), U13.7 (GND), U14.1 (GND), U14.3 (GND), U14.5 (GND), U14.7 (GND), U15.2 (GND)
unnamed: AE3.1 (A), J8.1 (In)
unnamed: C29.1, J1.1 (In)
unnamed: C19.2, J3.1 (In)
unnamed: C12.1, J4.1 (In)
unnamed: C6.1, J5.1 (In)
unnamed: J6.1 (In), J7.1 (In)
unnamed: J11.1 (In), J12.1 (In)
unnamed: J13.1 (In), U8.1 (In)
unnamed: J14.1 (In), U7.1 (In)
unnamed: J15.1 (In), U7.3 (Out2)
unnamed: J16.1 (In), U8.3 (Out2)
unnamed: C30.1, IQ_OUT.1 (In)
unnamed: JP1.2 (B), U9.1 (DSOP)
unnamed: C2.2, RV1.2, U1.5 (VT)
unnamed: R1.2, R2.1, U2.1 (ADJ)
unnamed: C9.1, U3.1 (RFIN)
unnamed: U4.4 (RF1), U5.2 (RF3)
unnamed: U4.6 (RF2), U5.8 (RF4)
unnamed: C28.1, U4.2 (RF3)
unnamed: U5.4 (RF1), U6.2 (RF3)
unnamed: U5.6 (RF2), U6.8 (RF4)
unnamed: R5.1, U7.2 (Out1)
unnamed: R6.1, U8.2 (Out1)
unnamed: C21.1, U9.4 (LOIN)
unnamed: C26.1, U9.3 (LOIP)
unnamed: R3.1, R4.2, U10.1 (ADJ)
unnamed: R7.2, R8.1, U11.2 (-)
unnamed: R9.2, R10.1, U11.6 (-)
unnamed: U13.4 (RF1), U14.2 (RF3)
unnamed: U13.6 (RF2), U14.8 (RF4)
unnamed: U6.4 (RF1), U13.2 (RF3)
unnamed: U6.6 (RF2), U13.8 (RF4)
unnamed: C5.1, U15.1 (RFIN)
VCC: C1.2, C4.2, C7.2, C8.2, C10.2, C11.2, C15.2, C16.2, C17.2, C22.2, C23.1, C24.1, C25.1, C27.2, J2.2, JP1.1 (A), L1.1, L2.1, R1.1, RV1.3, U1.7 (VCC), U2.2 (VO), U4.10 (VDD), U5.10 (VDD), U6.10 (VDD), U9.18 (VPS1), U9.24 (VPS2), U11.8 (V+), U13.10 (VDD), U14.10 (VDD)
VS: C3.2, C18.2, TP1.1, U2.3 (VI), U10.3 (VI)
