Saatvik-Aggarwal/phased-array/(commit log)

2026-02-12 minor design fixes for test pcb
    - gnd plane should not be on f.cu
    - remove solder mask on f.cu over antenna
    - add DC block capacitors on board outputs to VNA (to J1 and J18)
    [Amplifier_SBB5089Z.kicad_sch, SL_PhaseShift.kicad_sch, Vector_Modulator_TestBoard.kicad_sch, switchedPhaseShift.kicad_pcb, switchedPhaseShift.kicad_sch]
2026-02-13 generate gerbers
    [switchedPhaseShift.kicad_pcb]
2026-03-19 4 element phase shifter designed
    [Amplifier_SBB5089Z.kicad_sch, SL_PhaseShift.kicad_sch, Vector_Modulator_TestBoard.kicad_sch, switchedPhaseShift.kicad_sch]
2026-03-19 add new 4 element PCB
    [4phaseshift.kicad_pcb, 4phaseshift.kicad_sch, Amplifier_SBB5089Z.kicad_sch, SL_PhaseShift.kicad_sch, Vector_Modulator_TestBoard.kicad_sch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]
2026-03-19 deep's reciever project added
    [Rx antenna.kicad_pcb, Rx antenna.kicad_sch]
2026-03-20 gerbers generated for 4 element
    [4phaseshift-B_Cu.gbr, 4phaseshift-B_Mask.gbr, 4phaseshift-B_Paste.gbr, 4phaseshift-B_Silkscreen.gbr, 4phaseshift-Edge_Cuts.gbr, 4phaseshift-F_Cu.gbr, 4phaseshift-F_Mask.gbr, 4phaseshift-F_Paste.gbr]
2026-03-24 updated resistor values
    [4phaseshift.kicad_sch, Amplifier_SBB5089Z.kicad_sch, Vector_Modulator_TestBoard.kicad_sch]
2026-03-24 rx schematic drawn, need to update values
    [Rx antenna.kicad_sch]
2026-03-25 pcb for rx made
    [Rx antenna.kicad_pcb, Rx antenna.kicad_sch]
2026-03-25 updated impedance matching
    [Rx antenna.kicad_pcb, Rx antenna.kicad_sch]
2026-03-25 checked drc and fixed gnd plane
    [Rx antenna.kicad_pcb]
2026-04-08 saatvik mad
    [4phaseshift.kicad_pcb, Rx antenna.kicad_pcb, Rx antenna.kicad_sch]
